Maize-Toss/CBU-PCB/CBU-PCB-BOM.xlsx

Name | Value (Passives) | Designator | Quantity | Already Have? | Quantity Needed Per Board | Quantity Needed (3 Boards) | Manufacturer PN | Digikey Link | Supplier Unit Price | Supplier Subtotal | In cart?
Ceramic Capacitor 0805 | 1uF | C1, C7, C33, C35, C37, C38, C40 | 7 | MESH | 0 | 0 |  |  | n/a
Ceramic Capacitor 0603 | 100nF | C2, C6, C22.1, C22.2, C22.3, C22.4, C25, C26, C27, C28, C29, C30, C34 | 13 | MESH | 0 | 0 |  |  | n/a
Ceramic Capacitor 0603 | 10nF | C3, C5, C8, C32 | 4 | MESH | 0 | 0 |  |  | n/a
NFM18PS105R0J3D | 1uF (n/a) | C4 | 1 | no | 1 | 3 | NFM18PS105R0J3D | https://www.digikey.com/en/products/detail/murata-electronics/NFM18PS105R0J3D/2595173 | 0.13 | 0.39 | yes
Ceramic Capacitor 0603 | NC | C9, C14, C15, C16 | 4 | n/a | 0 | 0 |  |  | n/a
Ceramic Capacitor 0603 | 47pF precision | C10, C19 | 2 | no | 2 | 6 | CL10C470FB81PNC | https://www.digikey.com/en/products/detail/samsung-electro-mechanics/CL10C470FB81PNC/3887950 | 0.17 | 1.02
Ceramic Capacitor 0603 | 100pF precision | C11, C12, C17, C18 | 4 | no | 4 | 12 | CL10C101FB81PNC | https://www.digikey.com/en/products/detail/samsung-electro-mechanics/CL10C101FB81PNC/3887816 | 0.16 | 1.92
Ceramic Capacitor 0603 | 82pF precision | C13 | 1 | no | 1 | 3 | C0603C820F5GAC7867 | https://www.digikey.com/en/products/detail/kemet/C0603C820F5GAC7867/3471682 | 0.75 | 2.25
Ceramic Capacitor 0603 | 10pF precision | C20, C21 | 2 | no | 2 | 6 | C0603C100F5GAC7867 | https://www.digikey.com/en/products/detail/kemet/C0603C100F5GAC7867/3737121 | 0.35 | 2.1
Ceramic Capacitor 0603 | 16pF precision | C23, C24 | 2 | no | 2 | 6 | CBR06C160F5GAC | https://www.digikey.com/en/products/detail/kemet/CBR06C160F5GAC/3473742 | 0.45 | 2.7
Ceramic Capacitor 0603 | 4.7nF | C31 | 1 | MESH | 0 | 0 |  |  | n/a
Ceramic Capacitor 0603 | 68pF | C36, C39 | 2 | no | 2 | 6 | C0603C680F5HAC7867 | https://www.digikey.com/en/products/detail/kemet/C0603C680F5HAC7867/7946089 | 0.17 | 1.02
JZ500 |  | C41 | 1 | no | 1 | 3 | JZ500 | https://www.digikey.com/en/products/detail/knowles-voltronics/JZ500/6021624 | 4.6 | 13.8
APG1005CGC-T |  | D1, D2, D3 | 3 | no | 3 | 9 | APG1005CGC-T | https://www.digikey.com/en/products/detail/kingbright/apg1005cgc-t/4764964 | 0.39 | 3.51
742792042 |  | FB1, FB2, FB3 | 3 | no | 3 | 9 | 742792042 | https://www.digikey.com/en/products/detail/w%C3%BCrth-elektronik/742792042/4310358 | 0.21 | 1.89
731000114 |  | J1, J2, J3, J4, J5, J6, J7, J8, J9, J10, J11, J12 | 12 | yes | 0 | 0 |  |  | n/a
901481104 |  | J13 | 1 | no | 1 | 3 | 901481104 | https://www.digikey.com/en/products/detail/molex/0901481104/315103 | 1.42 | 4.26
5-146256-3 |  | J14 | 1 | no | 1 | 3 | 5-146256-3 | https://www.digikey.com/en/products/detail/te-connectivity-amp-connectors/5-146256-3/1153559 | 0.79 | 2.37
1714955 |  | J15 | 1 | no | 1 | 3 | 1714955 | https://www.digikey.com/en/products/detail/phoenix-contact/1714955/260637 | 1.87 | 5.61
744762256A | 560nH | L1, L2 | 2 | no | 2 | 6 | 744762256A | https://www.digikey.com/en/products/detail/w%C3%BCrth-elektronik/744762256a/1994241 | 0.47 | 2.82
M4 Mounting Hole |  | MH1, MH2, MH3, MH4 | 4 | n/a | 0 | 0 |  |  | n/a
Resistor 0603 | NC | R1, R3, R6, R10, R14, R15, R20, R23 | 8 | n/a | 0 | 0 |  |  | n/a
Resistor 0603 | 0 Ohm | R2, R5, R16, R17, R21, R22 | 6 | MESH | 0 | 0 |  |  | n/a
Resistor 0603 | 330 Ohm 0.1% | R4, R11 | 2 | no | 2 | 6 | TNPW0603330RBEEA | https://www.digikey.com/en/products/detail/vishay-dale/TNPW0603330RBEEA/1606710 | 0.57 | 3.42
Resistor 0603 | 3.3k Ohm | R7, R8, R9, R12, R13 | 5 | MESH | 0 | 0 |  |  | n/a
Resistor 0603 | 1M Ohm | R18.1, R18.2, R18.3, R18.4, R19.1, R19.2, R19.3, R19.4 | 8 | MESH | 0 | 0 |  |  | n/a
Resistor 0603 | 270 Ohm | R24, R25 | 2 | MESH | 0 | 0 |  |  | n/a
Resistor 0603 | 390 Ohm | R30 | 1 | MESH | 0 | 0 |  |  | n/a
Resistor 0603 | 38.3k Ohm 0.1% | R26 | 1 | no | 1 | 3 | ERA-3AEB3832V | https://www.digikey.com/en/products/detail/panasonic-electronic-components/ERA-3AEB3832V/2026890 | 0.31 | 0.93
Resistor 0603 | 23.2k Ohm 0.1% | R27 | 1 | no | 1 | 3 | ERA-3AEB2322V | https://www.digikey.com/en/products/detail/panasonic-electronic-components/ERA-3AEB2322V/2026869 | 0.31 | 0.93
Resistor 0603 | 30.9k Ohm 0.1% | R28 | 1 | no | 1 | 3 | ERA-3AEB3092V | https://www.digikey.com/en/products/detail/panasonic-electronic-components/ERA-3AEB3092V/2026881 | 0.31 | 0.93
Resistor 0603 | 16.5k Ohm 0.1% | R29 | 1 | no | 1 | 3 | ERA-3AEB1652V | https://www.digikey.com/en/products/detail/panasonic-electronic-components/ERA-3AEB1652V/2026856 | 0.31 | 0.93
TS04-66-50-BK-260-SMT |  | SW1 | 1 | no | 1 | 3 | TS04-66-50-BK-260-SMT | https://www.digikey.com/en/products/detail/cui-devices/ts04-66-50-bk-260-smt/15634371 | 0.18 | 0.54
ADT1-6T+ |  | T1 | 1 | no | 1 | 3 | ADT1-6T+ | https://www.digikey.com/en/products/detail/mini-circuits/ADT1-6T/13928280?s=N4IgTCBcDaIIIBEAqBGAtANiQahAXQF8g | 4.81 | 14.43
5000 |  | TP1, TP2, TP3, TP4, TP5, TP6, TP7, TP8, TP9, TP10, TP11, TP12, TP13, TP14, TP15, TP16, TP17, TP18, TP19 | 19 | MASA | 0 | 0 | 5000 |  | n/a
ST25R95-VMD5T |  | U1 | 1 | yes | 0 | 0 | ST25R95-VMD5T |  | n/a
PE42440MLBB-Z |  | U2.1, U2.2, U2.3, U2.4 | 4 | yes | 0 | 0 | PE42440MLBB-Z |  | n/a
STM32L452RET6P |  | U3 | 1 | yes | 0 | 0 | STM32L452RET6P |  | n/a
NCP3334DADJR2G |  | U4, U5 | 2 | no | 2 | 6 | NCP3334DADJR2G | https://www.digikey.com/en/products/detail/onsemi/ncp3334dadjr2g/1483660 | 1.15 | 6.9
ABM11W-27.1200MHZ-6-D1X-T3 |  | Y1 | 1 | no | 1 | 3 | ABM11W-27.1200MHZ-6-D1X-T3 | https://www.digikey.com/en/products/detail/abracon-llc/ABM11W-27-1200MHZ-6-D1X-T3/7172650 | 0.76 | 2.28
ABM3B-8.000MHZ-B2-T |  | Y2 | 1 | no | 1 | 3 | ABM3B-8.000MHZ-B2-T | https://www.digikey.com/en/products/detail/abracon-llc/abm3b-8-000mhz-b2-t/1873166 | 0.72 | 2.16
 |  |  |  |  |  |  |  |  | Total: | 79.11
