Maize-Toss/CBU-PCB/CBU-PCB_Schematic_Printout.pdf

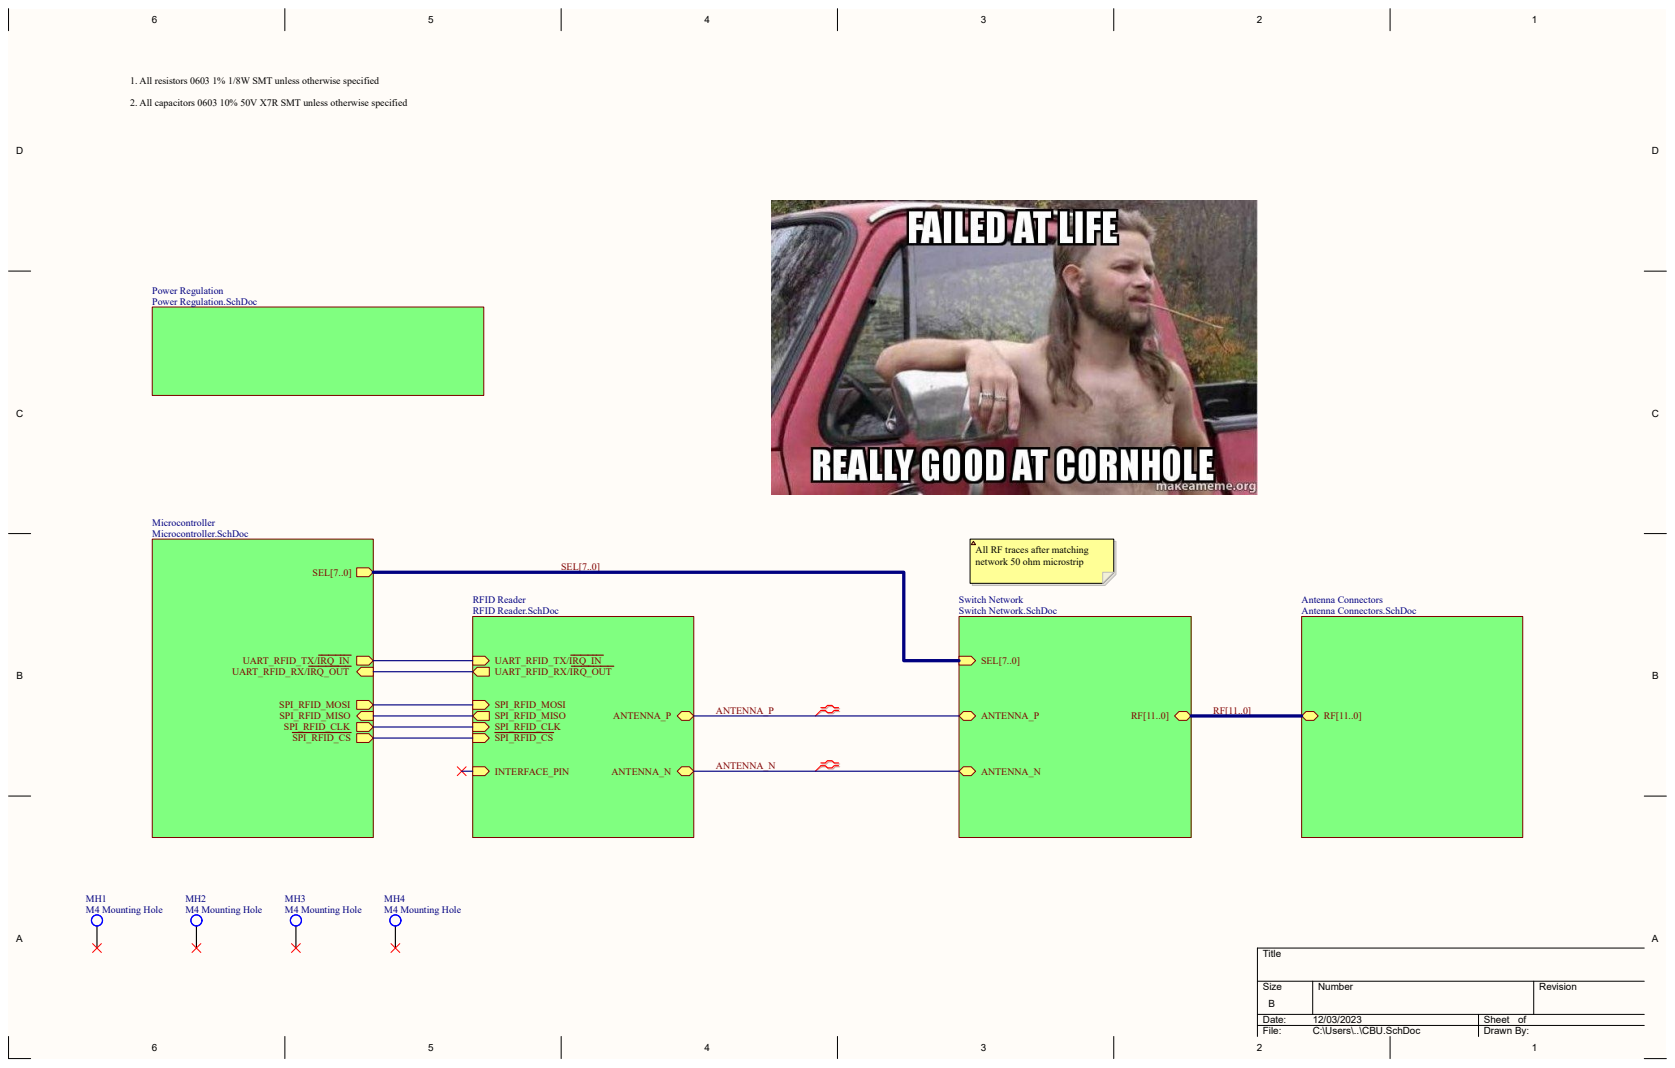
[picture p1: page 1]
A A Title; Size; Number; Revision; Date:; Sheet of; File:; C:\Users\..\CBU.SchDoc; Drawn By:; ANTENNA_N; ANTENNA_P; INTERFACE_PIN; UART_RFID_TX/IRQ_IN UART_RFID_RX/IRQ_OUT; SPI_RFID_MOSI SPI_RFID_MISO SPI_RFID_CLK SPI_RFID_CS; SEL[7..0]; Microcontroller Microcontroller.SchDoc; MH1 M4 Mounting Hole; MH2 M4 Mounting Hole; MH3 M4 Mounting Hole; MH4 M4 Mounting Hole

1. All resistors 0603 1% 1/8W SMT unless otherwise specified

2. All capacitors 0603 10% 50V X7R SMT unless otherwise specified

Power Regulation
Power Regulation.SchDoc

All RF traces after matching
network 50 ohm microstrip

RFID Reader
RFID Reader.SchDoc

Switch Network
Switch Network.SchDoc

Antenna Connectors
Antenna Connectors.SchDoc

# C3 ¹ ²

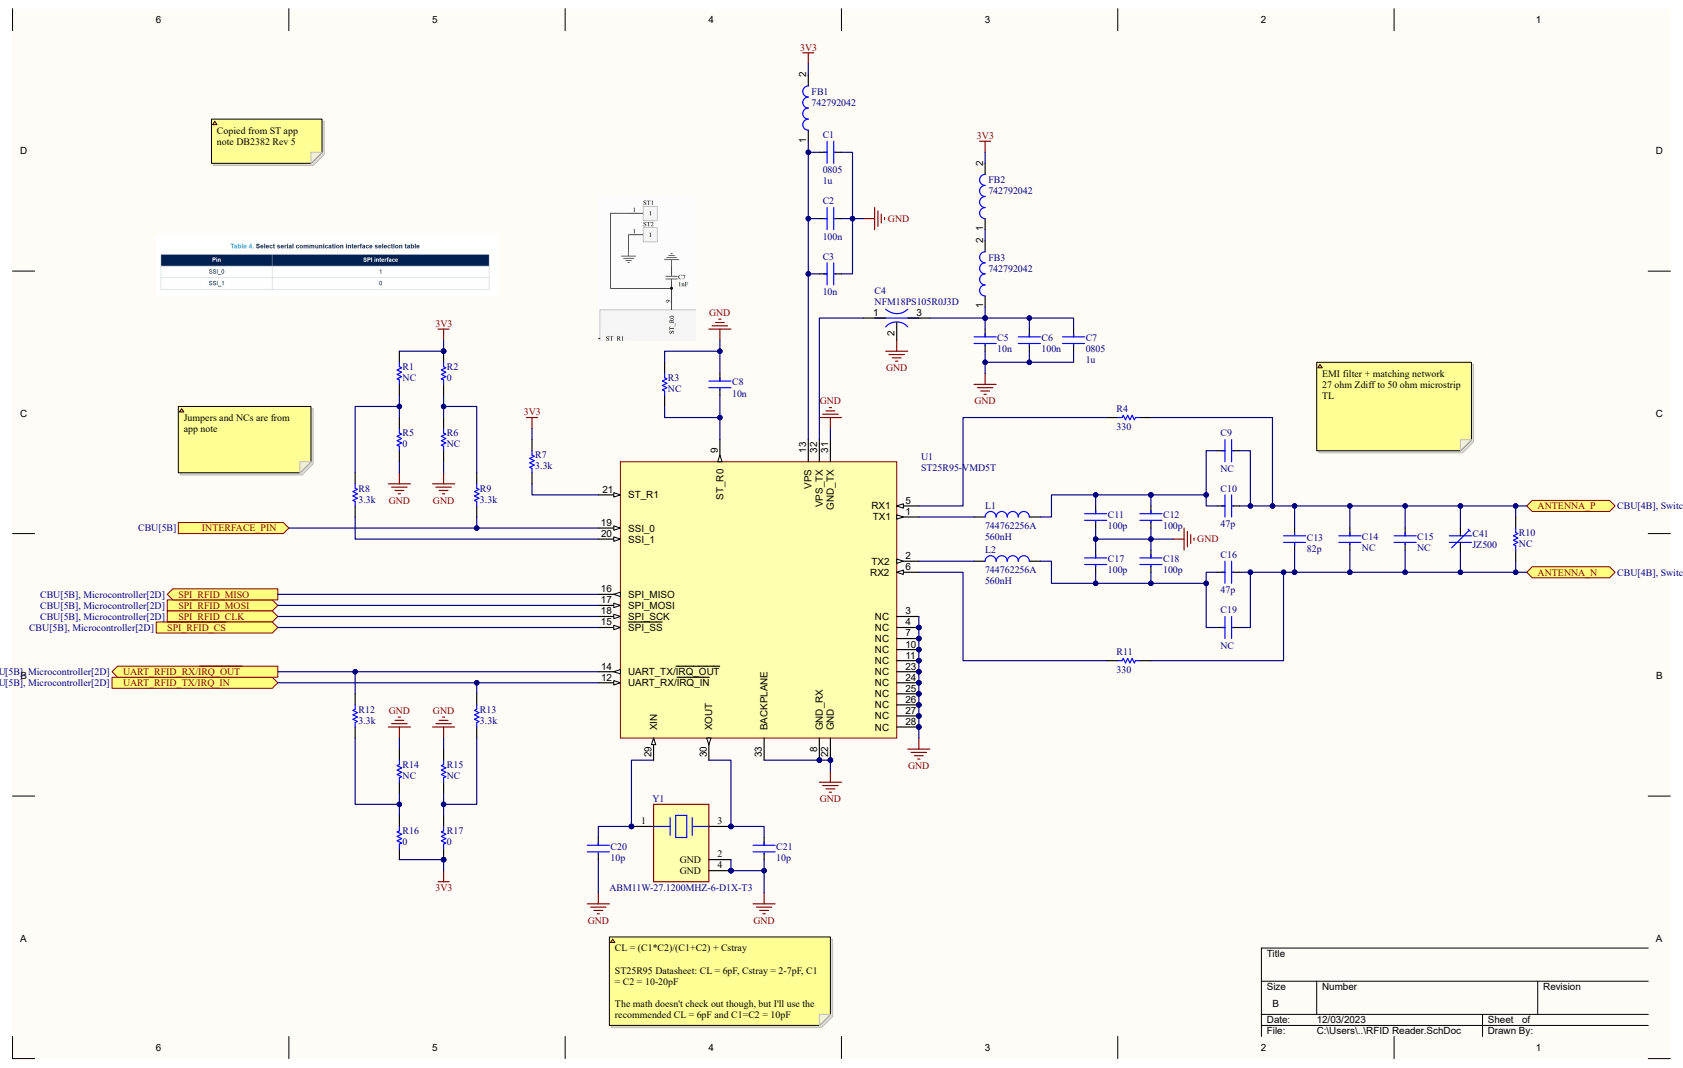
[picture p2: page 2]

Copied from ST app
note DB2382 Rev 5

EMI filter + matching network
27 ohm Zdiff to 50 ohm microstrip

Jumpers and NCs are from
app note

The math doesn't check out though, but I'll use the
recommended CL = 6pF and C1=C2 = 10pF

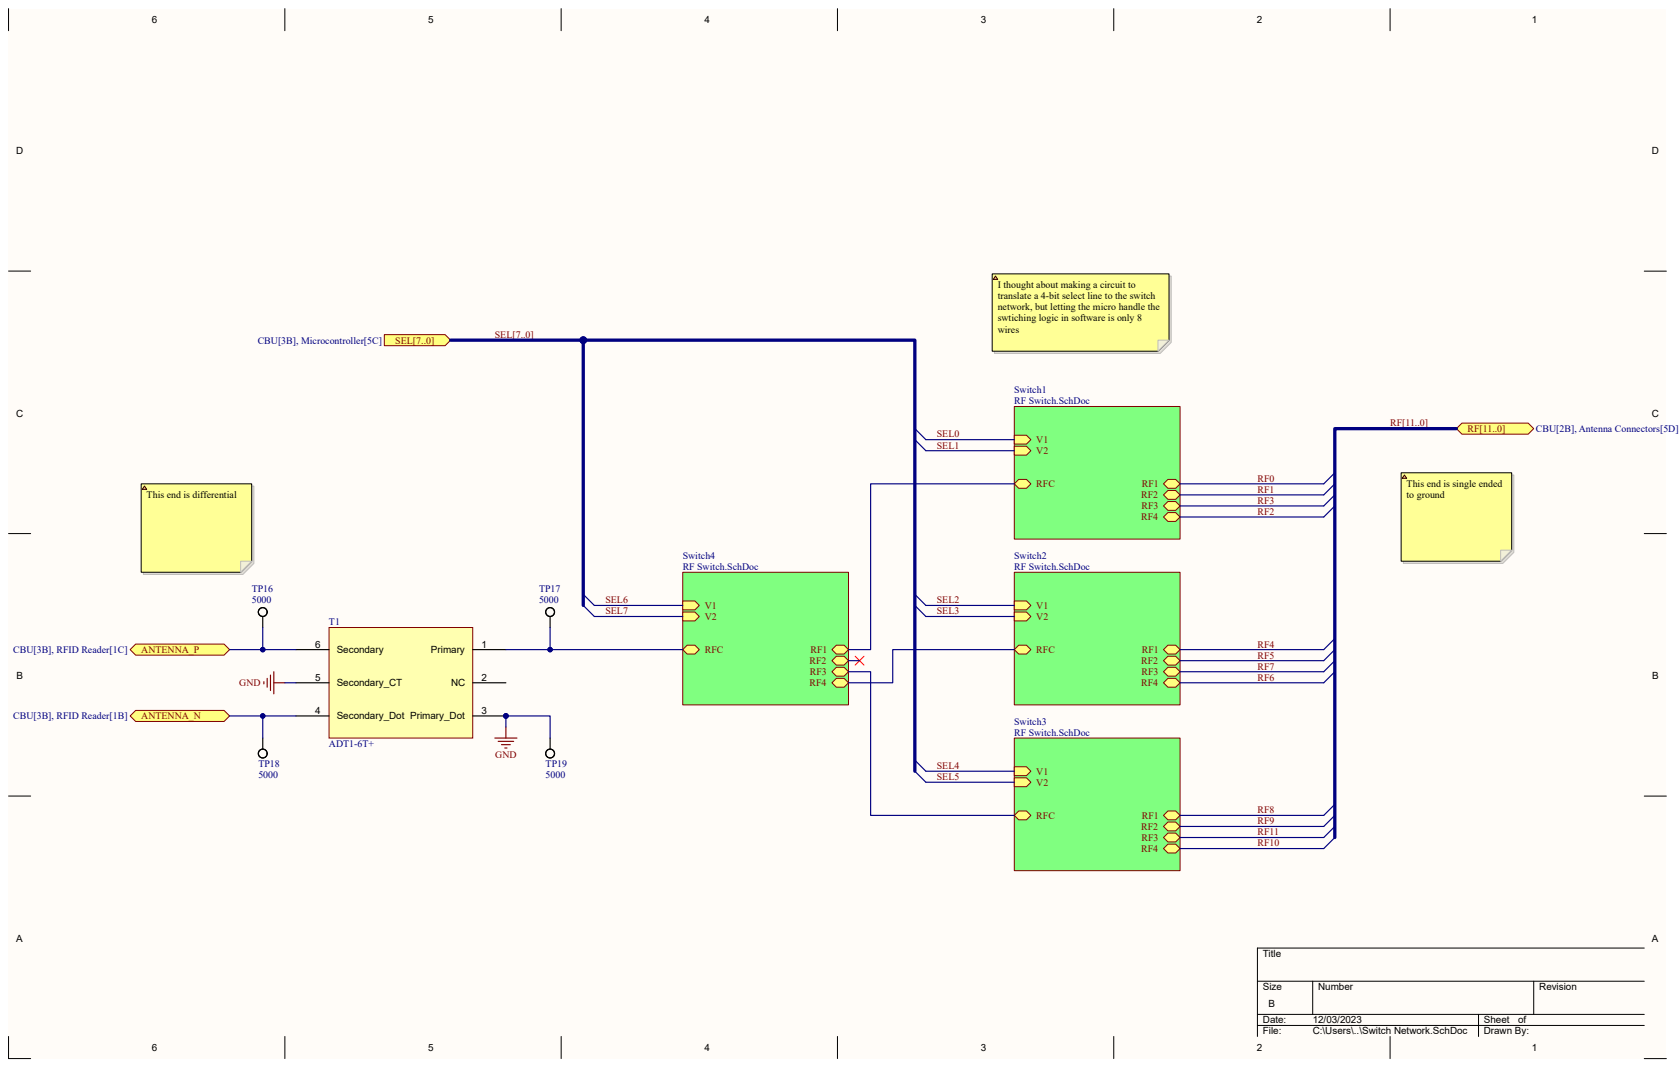
[picture p3: page 3]
A A Title; File:; C:\Users\..\Switch Network.SchDoc; Drawn By:; RFC; SEL0 SEL1; SEL2 SEL3; SEL4 SEL5; SEL6 SEL7; SEL[7..0]; CBU[3B], Microcontroller[5C]; CBU[2B], Antenna Connectors[5D], RF Switch[4B]; Secondary_CT 5; Secondary 6; Secondary_Dot 4; Primary_Dot; Primary; ADT1-6T+; CBU[3B], RFID Reader[1C]; ANTENNA_P; GND; CBU[3B], RFID Reader[1B]; ANTENNA_N; This end is differential; to ground

I thought about making a circuit to
translate a 4-bit select line to the switch
network, but letting the micro handle the
swtiching logic in software is only 8
wires

Switch1
RF Switch.SchDoc

This end is single ended

Switch4

Switch2

Switch3

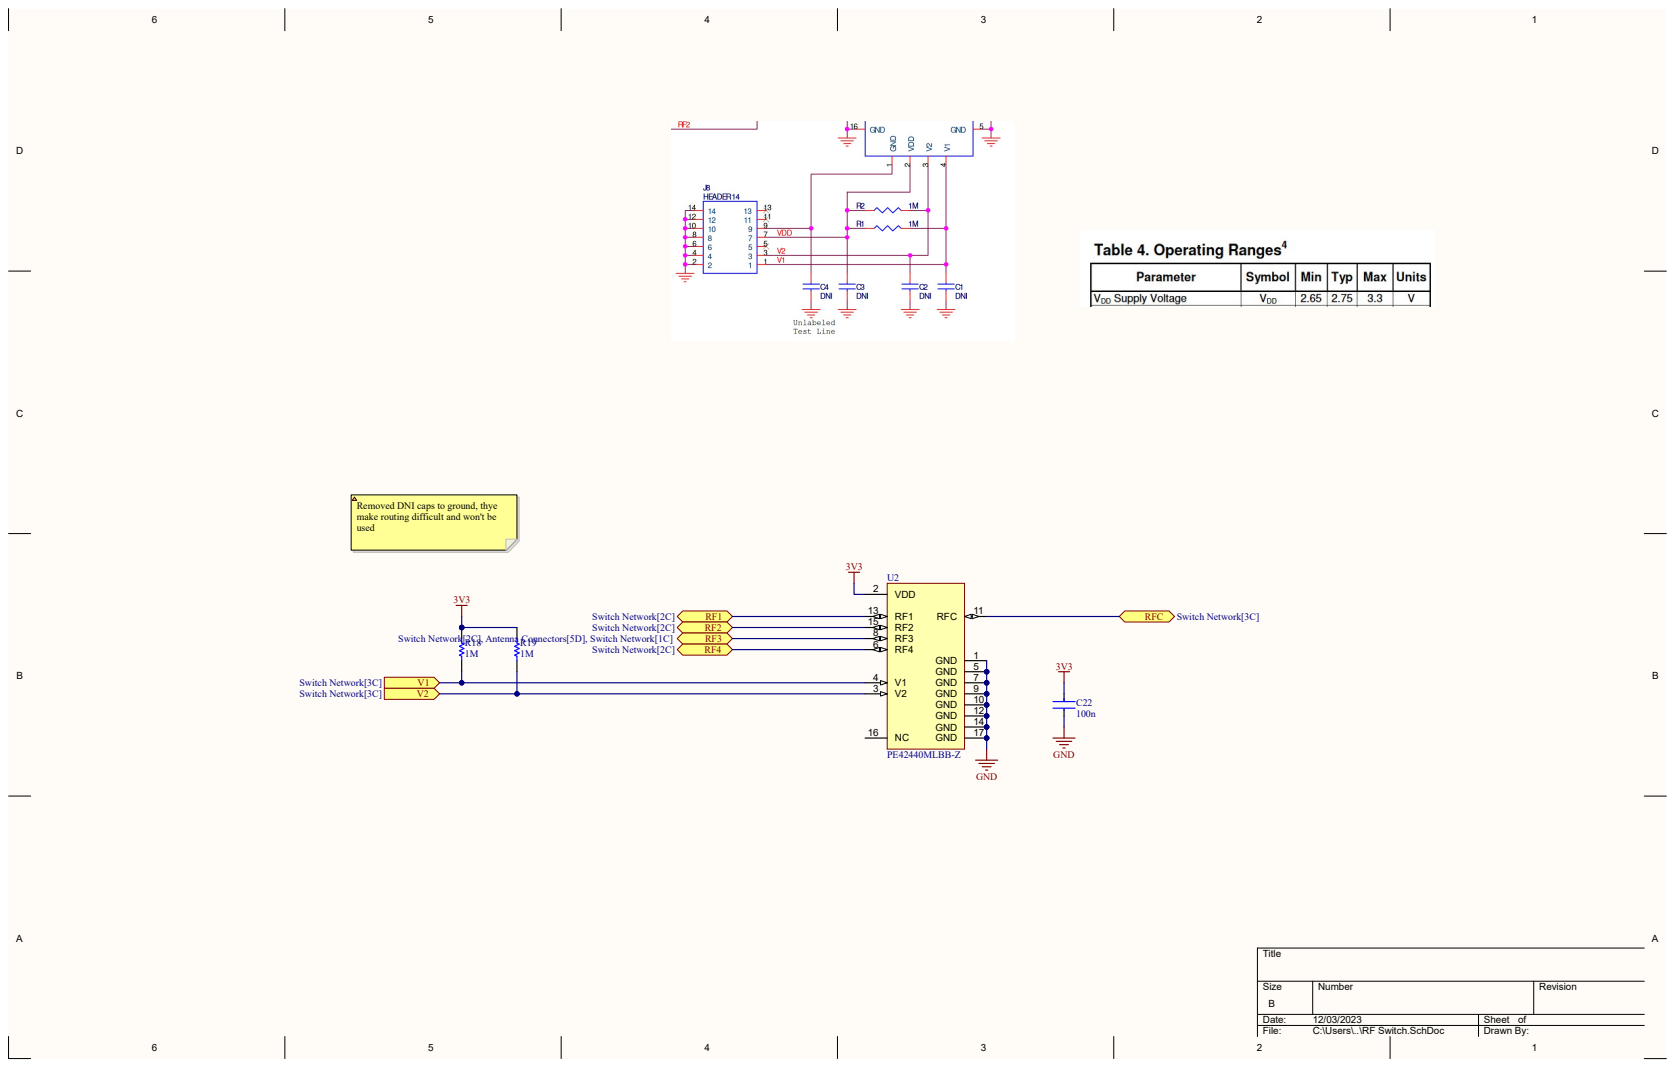
[picture p4: page 4]
A A Title; File:; C:\Users\..\RF Switch.SchDoc; Drawn By:; GND; VDD 2; RFC; PE42440MLBB-Z; Switch Network[3C]; Switch Network[2C]; Switch Network[2C], Antenna Connectors[5D], Switch Network[1C]

Removed DNI caps to ground, thye
make routing difficult and won't be
used

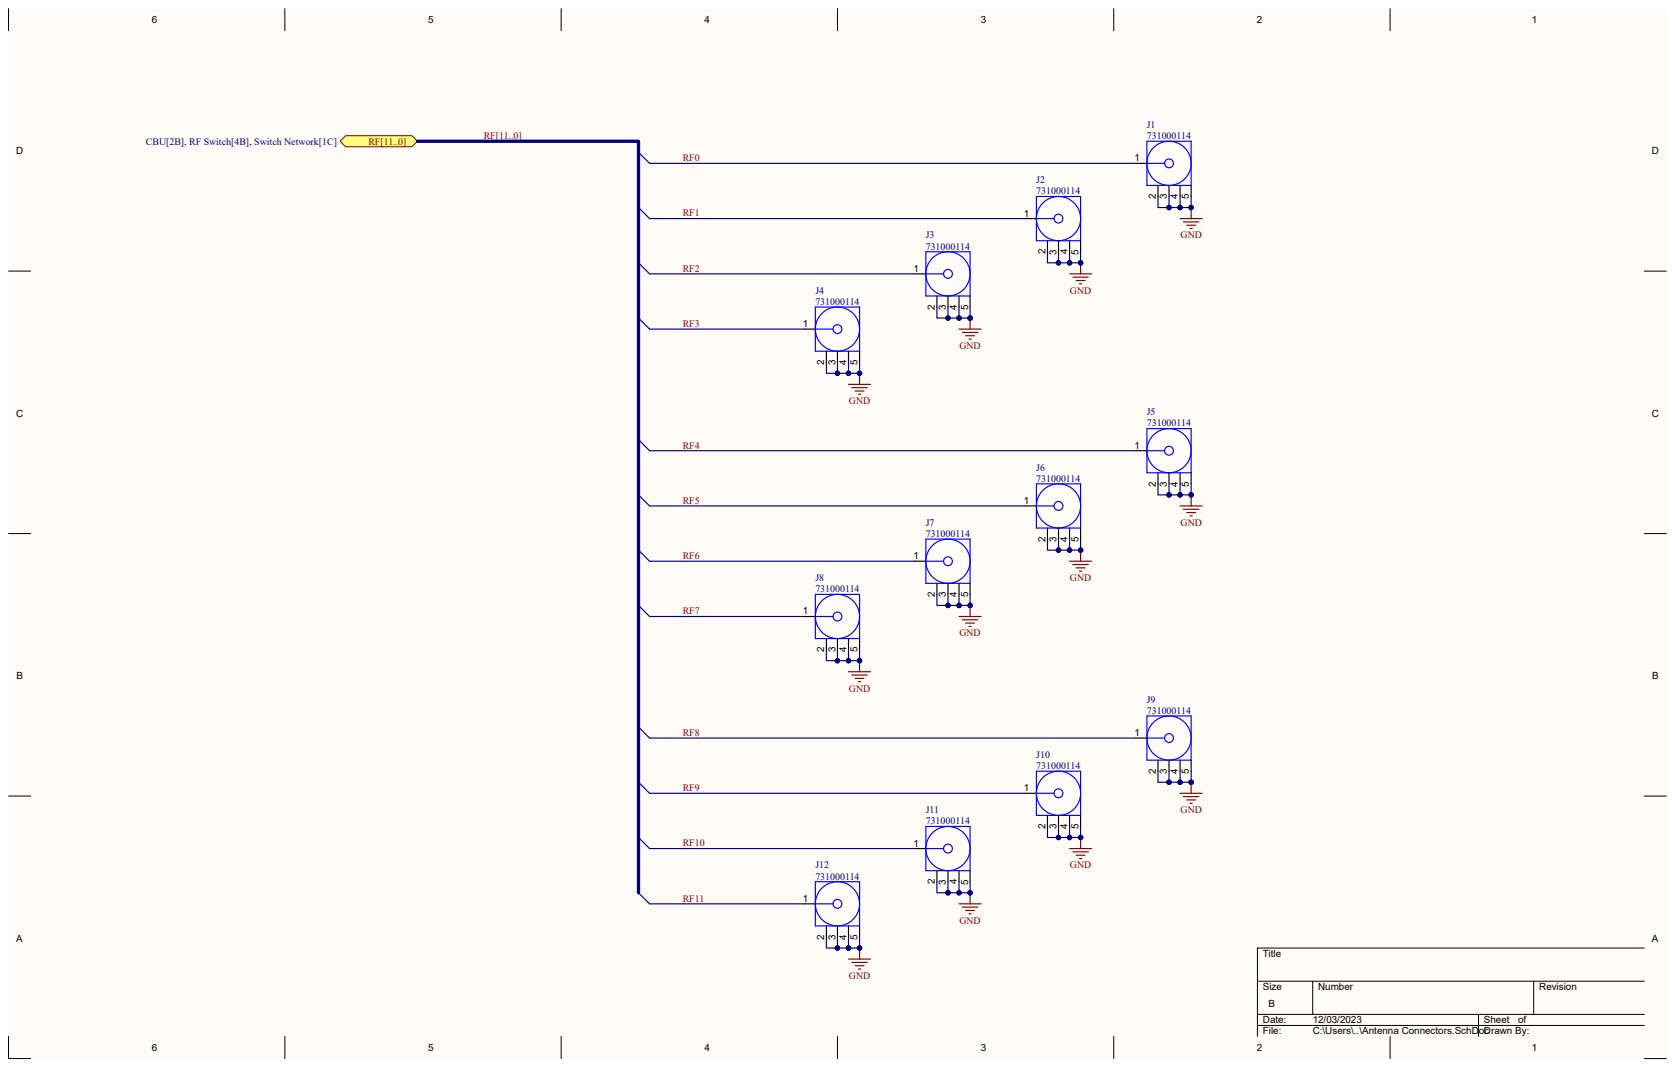
[picture p5: page 5]

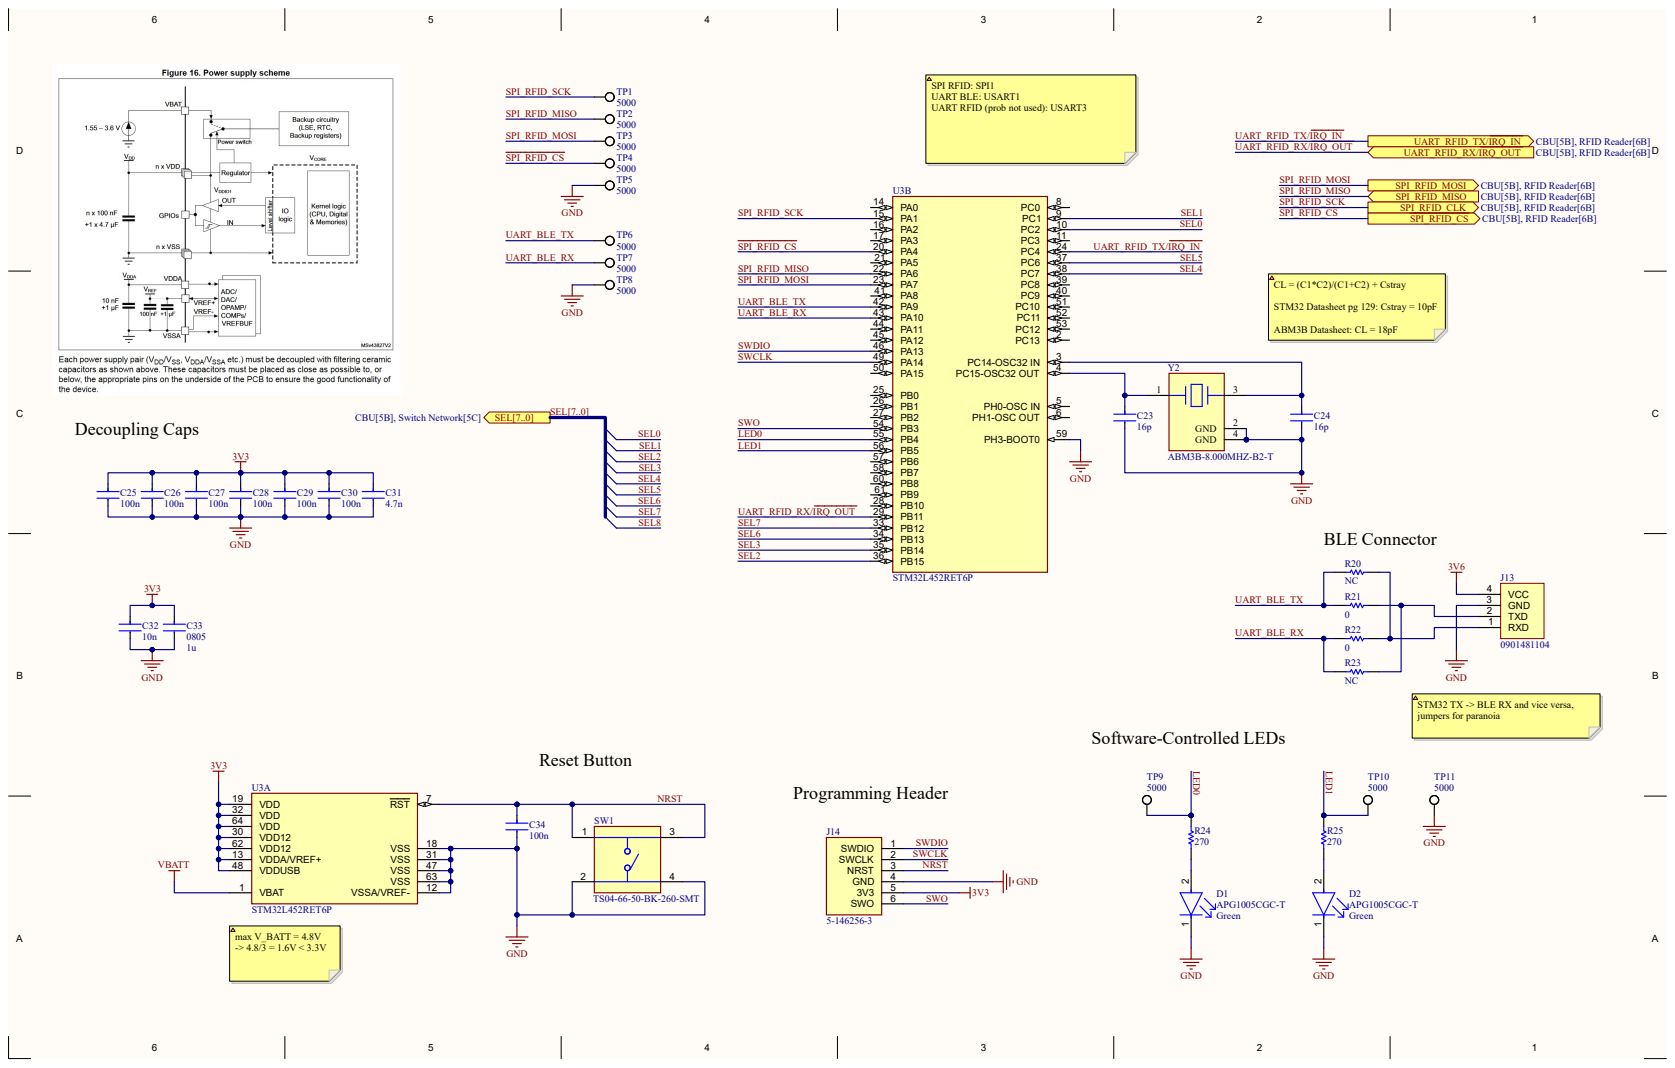
[picture p6: page 6]

SPI RFID: SPI1
UART BLE: USART1
UART RFID (prob not used): USART3

STM32 TX -> BLE RX and vice versa,
jumpers for paranoia

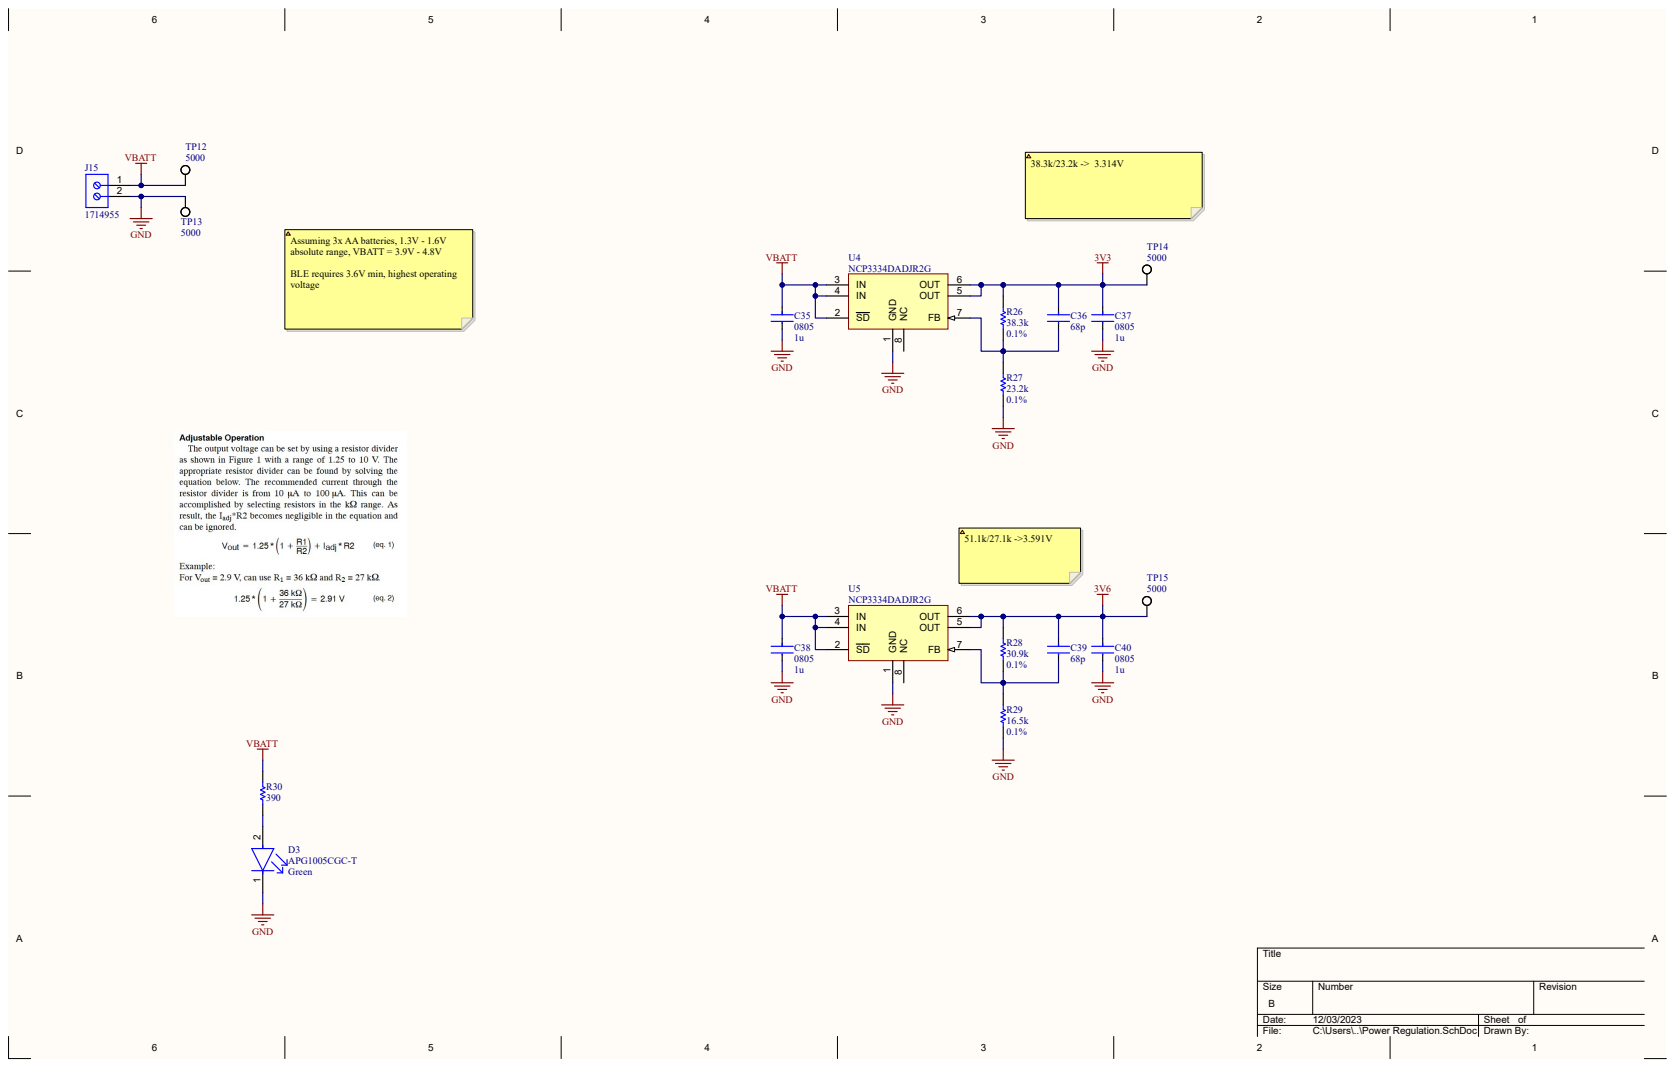
[picture p7: page 7]

BLE requires 3.6V min, highest operating
voltage
