Maize-Toss/CBU-PCB/(list of files, drawings)

Other design files:
Antenna Connectors.SchDoc
CBU-PCB.PcbDoc
CBU-PCB.PcbLib
CBU-PCB.PrjPcb
CBU-PCB.SchLib
CBU.SchDoc
Microcontroller.SchDoc
Power Regulation.SchDoc
RF Switch.SchDoc
RFID Reader.SchDoc
Switch Network.SchDoc
