Maize-Toss/CBU-PCB/(commit log)

2023-10-06 Started making components
    [CBU-PCB.PcbDoc, CBU-PCB.PcbLib, CBU-PCB.PrjPcb, CBU-PCB.SchLib, CBU.SchDoc]
2023-10-10 Added more ICs and connector parts
    [CBU-PCB.PcbDoc, CBU-PCB.PcbLib, CBU-PCB.PrjPcb, CBU-PCB.SchLib, CBU.SchDoc]
2023-10-10 Still adding parts
    [CBU-PCB.SchLib, CBU.SchDoc]
2023-10-11 Added more components
    [CBU-PCB.PcbDoc, CBU-PCB.PcbLib, CBU-PCB.SchLib, CBU.SchDoc]
2023-10-11 Forgot to save last time lol
    [CBU-PCB.PrjPcb]
2023-10-12 Adding more parts
    [CBU-PCB Power Budget.xlsx, CBU-PCB.PcbLib, CBU-PCB.PrjPcb, CBU-PCB.SchLib, CBU.SchDoc]
2023-10-12 added linear reg
    [CBU-PCB.PcbLib, CBU-PCB.SchLib, CBU.SchDoc]
2023-10-13 Drew the schematic first draft. Missing a couple things, including some jumpers, button, correct oscillators, and maybe I need another power rail
    [Antenna Connectors.SchDoc, CBU-PCB.PcbDoc, CBU-PCB.PcbLib, CBU-PCB.PrjPcb, CBU-PCB.SchLib, CBU.SchDoc, Microcontroller.SchDoc, Power Regulation.SchDoc]
2023-10-13 added schematic pdf
2023-10-19 Added 3V rail, picked LED
    [CBU-PCB.PcbLib, CBU-PCB.SchLib, Microcontroller.SchDoc, Power Regulation.SchDoc]
2023-10-19 Changed power rails to 3v3 and 3v6 only
    [Antenna Connectors.SchDoc, CBU.SchDoc, Microcontroller.SchDoc, Power Regulation.SchDoc, RF Switch.SchDoc, RFID Reader.SchDoc, Switch Network.SchDoc]
2023-10-20 added balun footprint/symbol
    [CBU-PCB.PcbLib, CBU-PCB.SchLib]
2023-10-20 Added switch, rfid crystal, and micro crystal
    [Antenna Connectors.SchDoc, CBU-PCB.PcbLib, CBU-PCB.SchLib, CBU.SchDoc, Microcontroller.SchDoc, Power Regulation.SchDoc, RF Switch.SchDoc, RFID Reader.SchDoc]
2023-10-20 added balun footprint (again)
    [CBU-PCB.PcbLib]
2023-10-23 cleaned up library, everything is in local lib files now. ERC passes except for inconsequential errors (power not a driving source, i/o doesn't like connecting to either input or output, can change E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
    [Antenna Connectors.SchDoc, CBU-PCB.PcbDoc, CBU-PCB.PcbLib, CBU-PCB.PrjPcb, CBU-PCB.SchLib, CBU.SchDoc, Microcontroller.SchDoc, Power Regulation.SchDoc]
2023-10-25 Added 0805 cap footprint for 1uF caps, did initial placement
    [Antenna Connectors.SchDoc, CBU-PCB.PcbDoc, CBU-PCB.PcbLib, CBU-PCB.PrjPcb, CBU-PCB.SchLib, CBU.SchDoc, Microcontroller.SchDoc, Power Regulation.SchDoc]
2023-10-26 More placement, changed size, added test points, need to add mounting holes still
    [Antenna Connectors.SchDoc, CBU-PCB.PcbDoc, CBU-PCB.PcbLib, CBU-PCB.SchLib, CBU.SchDoc, Microcontroller.SchDoc, Power Regulation.SchDoc, RF Switch.SchDoc]
2023-10-26 Cleaned up placement, ready to route
    [CBU-PCB.PcbDoc]
2023-10-26 routed most traces. TODO: add more silkscreen labels, add mounting holes, shuffle led and select pins around on the micro, route antenna diff pair
    [CBU-PCB.PcbDoc, Switch Network.SchDoc]
2023-10-27 Before autorouting the rest
    [CBU-PCB.PcbDoc]
2023-10-27 Routing led and sel by hand
    [CBU-PCB.PcbDoc, CBU-PCB.PcbLib, CBU-PCB.PrjPcb, Microcontroller.SchDoc]
2023-10-30 Finished layout
    [CBU-PCB.PcbDoc, CBU-PCB.PcbLib, CBU-PCB.SchLib, CBU.SchDoc, Microcontroller.SchDoc, RFID Reader.SchDoc]
2023-10-30 Saved project
    [CBU-PCB.PrjPcb]
2023-10-31 Added rf test points on either side of balun
    [CBU-PCB.PcbDoc, Switch Network.SchDoc]
2023-10-31 Exported manufacturing files for JLC
    [CBU-PCB.GBL, CBU-PCB.GBO, CBU-PCB.GBP, CBU-PCB.GBS, CBU-PCB.GM1, CBU-PCB.GTL, CBU-PCB.GTO, CBU-PCB.GTP]
2023-11-02 Wrote BOM
    [CBU-PCB-BOM.xlsx, CBU-PCB.PcbDoc, CBU-PCB.PrjPcb, CBU-PCB.SchLib, Microcontroller.SchDoc, Power Regulation.SchDoc, Switch Network.SchDoc]
2023-11-03 Redid placement and did layout, need to fix DRC
    [CBU-PCB-BOM.xlsx]
2023-12-04 Updated schematic pdf
    [CBU-PCB-BOM.xlsx]
